TKDFusion/3DPrinter-Printer-AnnexEngineering-Gasherbrum-K3/Release_1_2/STLs/XY_Carriage/chube_compact_hotend/sherpa_mini_chube_compact_main_body_x1_rev1.STL

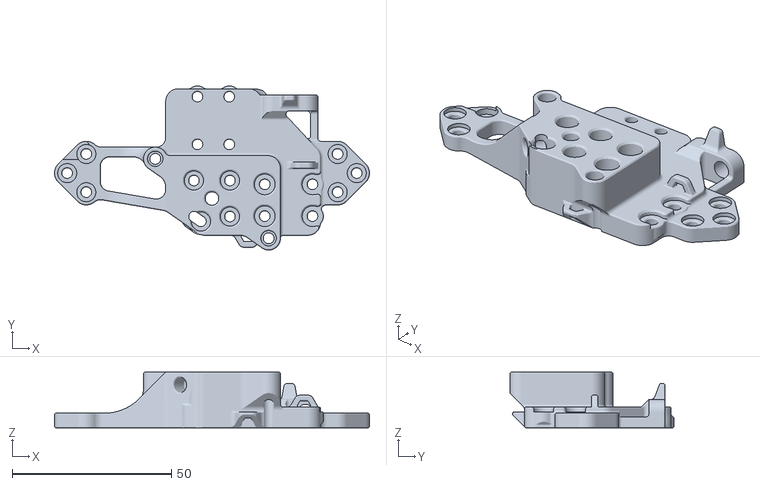
[picture p2: CAD file, 2026-05-04]
Release_1_2/STLs/XY_Carriage/chube_compact_hotend/sherpa_mini_chube_compact_main_body_x1_rev1.STL
99.0 x 51.6 x 17.5
