TKDFusion/3DPrinter-Printer-AnnexEngineering-Gasherbrum-K3/Release_1_2/STLs/XY_Carriage/chube_compact_hotend/chube_compact_fan_shroud_outlet_x1_rev1.STL

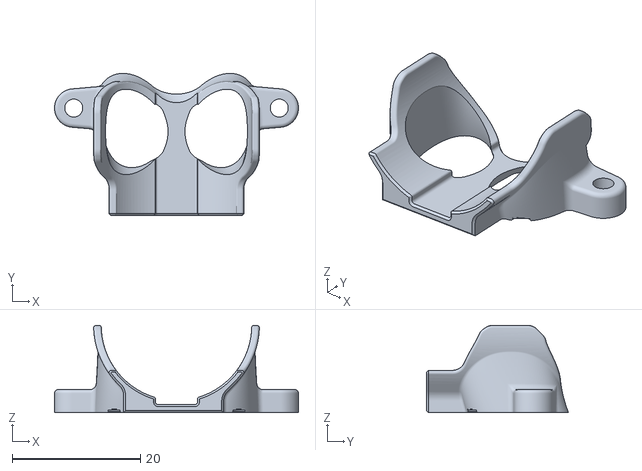
[picture p3: CAD file, 2026-05-04]
Release_1_2/STLs/XY_Carriage/chube_compact_hotend/chube_compact_fan_shroud_outlet_x1_rev1.STL
38.0 x 22.2 x 13.6
