TKDFusion/3DPrinter-Printer-AnnexEngineering-Gasherbrum-K3/Release_1_2/STLs/XY_Carriage/chube_compact_hotend/chube_compact_brace_for_probe_mount_x1_rev2.STL

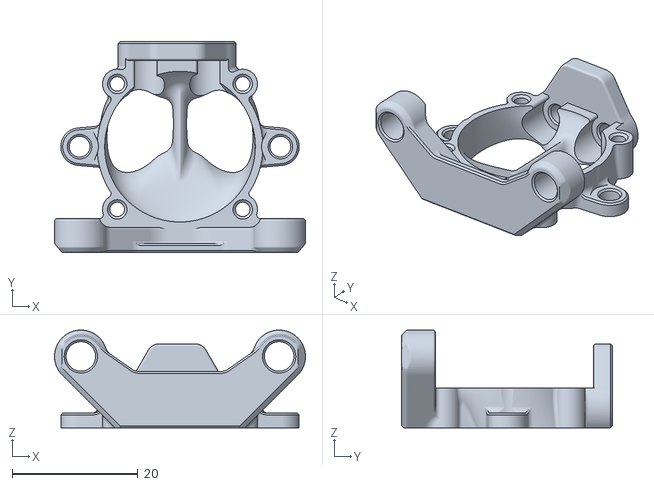
[picture p4: CAD file, 2026-05-04]
Release_1_2/STLs/XY_Carriage/chube_compact_hotend/chube_compact_brace_for_probe_mount_x1_rev2.STL
40.0 x 33.6 x 15.6
