TKDFusion/3DPrinter-Printer-AnnexEngineering-Gasherbrum-K3/Release_1_2/STLs/XY_Carriage/chube_compact_hotend/rail_cart_screw_spacer_0.5mm_x1_rev1.STL

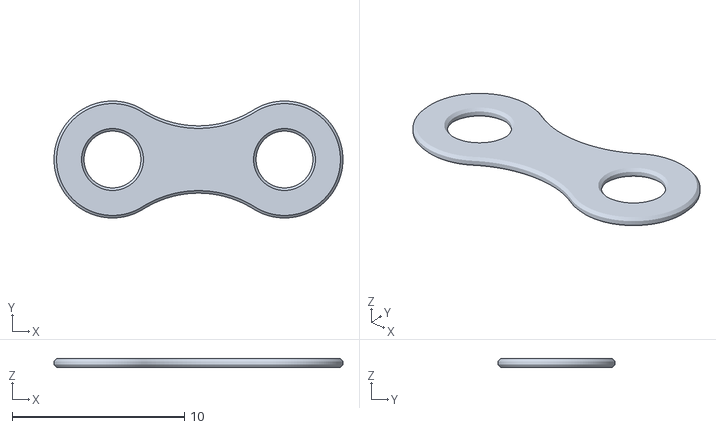
[picture p5: CAD file, 2026-05-04]
Release_1_2/STLs/XY_Carriage/chube_compact_hotend/rail_cart_screw_spacer_0.5mm_x1_rev1.STL
16.8 x 6.80 x 0.5
