TKDFusion/3DPrinter-Printer-AnnexEngineering-Gasherbrum-K3/(list of files, cad)

Other CAD files:
Release_1_2/STLs/XY_Carriage/chube_compact_hotend/ascender_chube_compact_main_body_x1_rev1.STL
